NimMM90/WirelessButtons/Images/Back.jpg

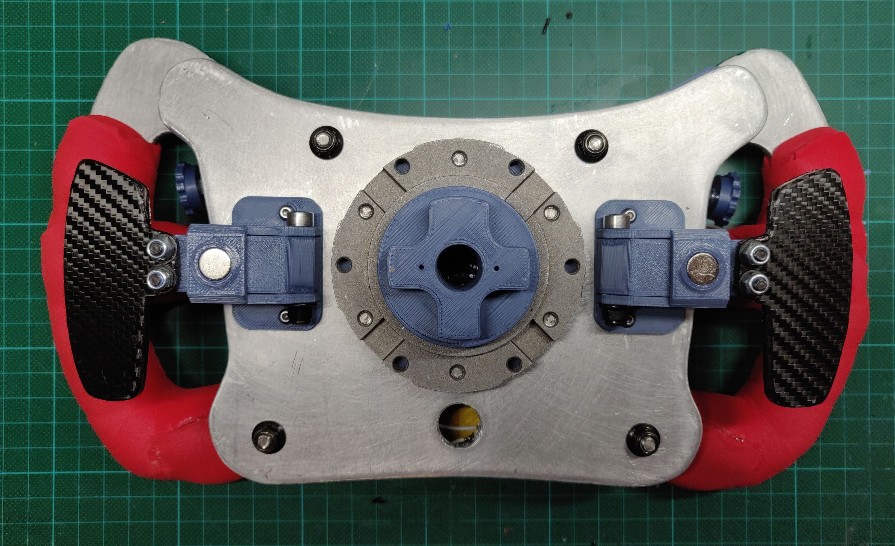
Images/Back.jpg
