NimMM90/WirelessButtons/Images/Bar_Tape.jpg

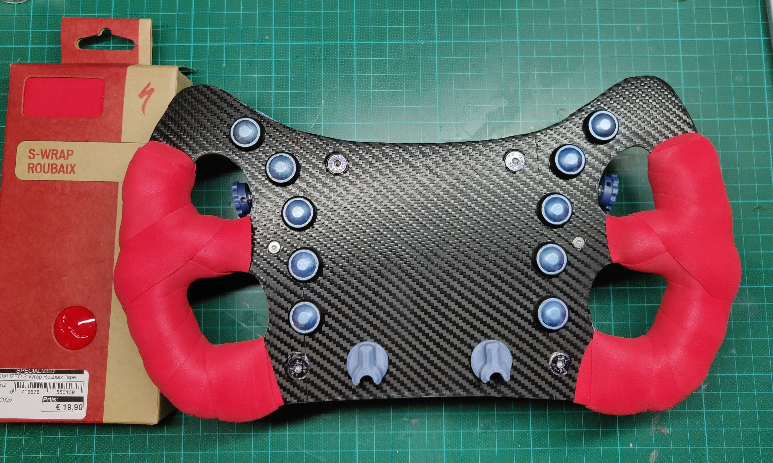
Images/Bar_Tape.jpg
