NimMM90/WirelessButtons/Images/Bottom.jpg

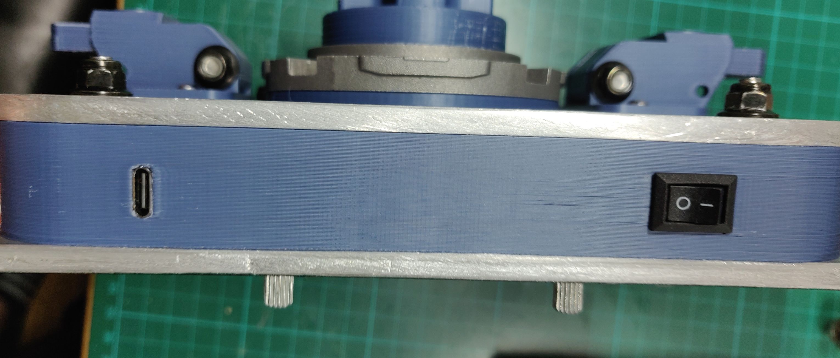
Images/Bottom.jpg
