NimMM90/WirelessButtons/Images/Compared_T300_Wheel.jpg

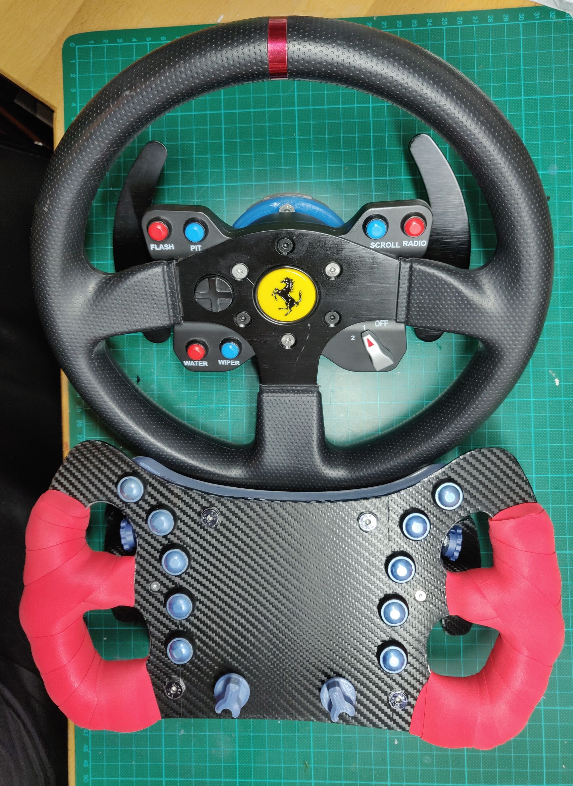
Images/Compared_T300_Wheel.jpg
