NimMM90/WirelessButtons/Images/Rear_JST.jpg

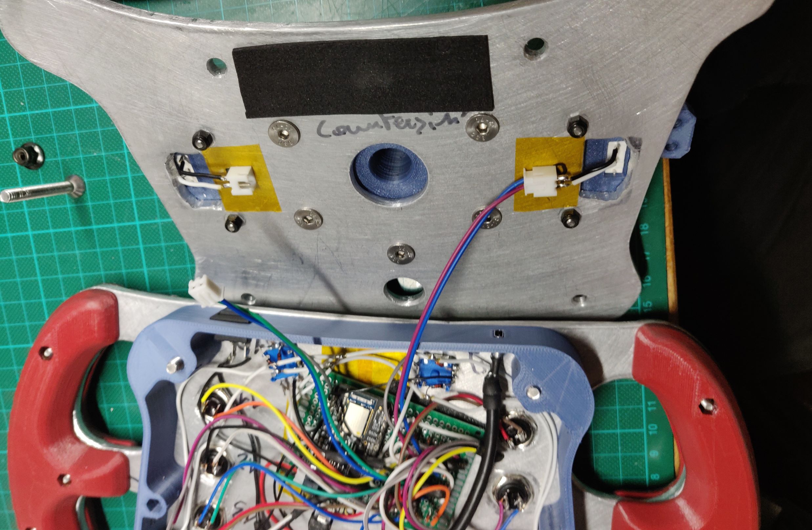
Images/Rear_JST.jpg
