NimMM90/WirelessButtons/(commit log)

2021-05-18 Actually back in a working state, upstream master is totally broken
    [battery.h, buttonhid.h, buttonplate.h, vars.h, wireless_button_sender.ino]
2021-05-18 Cleaned up folder structure
    Reverted the Battery monitor to the Adafruit example (~within 3% or so on my 18650s)
    [battery.h, buttonhid.h, buttonplate.h, vars.h, wireless_button_sender.ino]
2021-05-19 Working version with encoders
    maybe has a debounce/encoder signal issue on fast rotations
    [buttonplate.h]
2021-05-19 changed pin assignment as pin 30 was being flaky
